dimhoff/ser4010/hardware/schematic/ser4010.kicad_pcb

## KiCad design hardware/schematic/ser4010.kicad_pcb (2018-09-15)

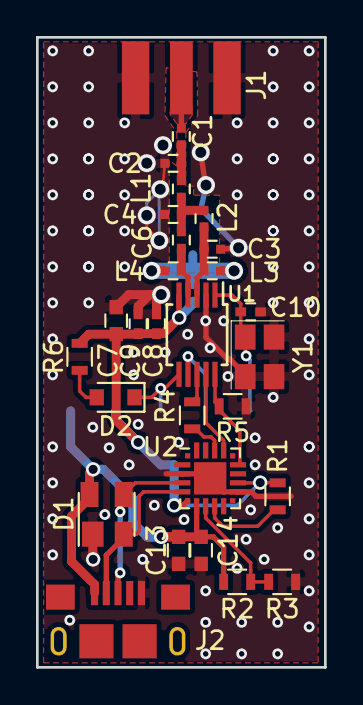
[picture p1: board ser4010.kicad_pcb from above]

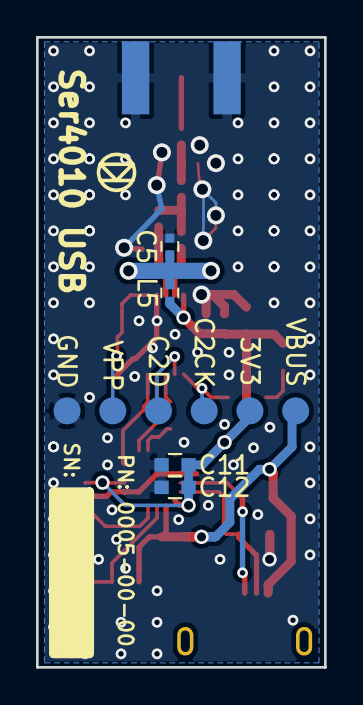
[picture p2: board ser4010.kicad_pcb from below]

Board: 2 copper layers, 16.0 x 35.0 mm, 38 parts (10 on the bottom side), 21 nets.

Parts:
C1, C9: 270pF; C_0402
C2, C4: 6.8pF; C_0402
C3: 4.3pF; C_0402
C5: 2.7pF; C_0402
C6: 1.8pF; C_0402
C7: 2.2uF; C_0603
C8: 1nF; C_0402
C10: 5pF; C_0402
C11, C13: 4.7uF; C_0603
C12, C14: 0.1uF; C_0603
D1: SP0503BAHT; SOT-143
D2: LED; D_0805
J1: Conn_Coaxial; Adafruit-SMA_EDGELAUNCH
J2: USB_OTG; Amphenal_FCI_10118193-0001LF_USB_Micro-B
J3: 3V3; Measurement_Point_Round-SMD-Pad_Small-Labeled
J4: VPP; Measurement_Point_Round-SMD-Pad_Small-Labeled
J5: C2CK; Measurement_Point_Round-SMD-Pad_Small-Labeled
J6: C2D; Measurement_Point_Round-SMD-Pad_Small-Labeled
J7: GND; Measurement_Point_Round-SMD-Pad_Small-Labeled
J8: VBUS; Measurement_Point_Round-SMD-Pad_Small-Labeled
L1: 18nH; C_0402
L2: 56nH; C_0402
L3, L4: 16nH; C_0402
L5: 220nH; C_0402
R1: 1k; R_0603
R2: 22.1k; R_0603
R3: 47.5k; R_0603
R4: 100; R_0603
R5: DNF; R_0603
R6: 470; R_0603
U1: Si4010-GT; MSOP-10_3x3mm_Pitch0.5mm
U2: CP2102N-A01-GQFN20; SiliconLabs_QFN-20-1EP_3x3mm_Pitch0.5mm
Y1: LFXTAL055915; Crystal_SMD_IQD_CFPX-180_4pin_3.2x2.5mm

Connections:
+3V3: C7.1, C8.1, C9.1, C11.1, C12.1, J3.1, L5.1, R1.1, R6.2, U1.5, U2.6, U2.13
/D+: D1.3, J2.3, U2.4
/D-: D1.2, J2.2, U2.5
/VBUS: C13.1, C14.1, D1.4, J2.1, J8.1, R2.1, U2.7
GND: C2.2, C3.2, C4.2, C5.1, C7.2, C8.2, C9.2, C10.1, C11.2, C12.2, C13.2, C14.2, D1.1, J1.2, J2.5, J7.1, R3.2, R5.1, U1.2, U2.3, U2.12, U2.21, Y1.2, Y1.3, Y1.4
unnamed: C1.1, C2.1, L1.2
unnamed: C1.2, J1.1
unnamed: C3.1, L2.1, L3.1, U1.3
unnamed: C4.1, C6.2, L1.1, L2.2
unnamed: C5.2, L3.2, L4.1, L5.2
unnamed: C6.1, L4.2, U1.4
unnamed: C10.2, J4.1, U1.1, Y1.1
unnamed: D2.1, J5.1, U1.6
unnamed: D2.2, R6.1
unnamed: J6.1, U1.7
unnamed: R1.2, U2.9
unnamed: R2.2, R3.1, U2.8
unnamed: R4.1, U1.8
unnamed: R4.2, U2.18
unnamed: R5.2, U1.10, U2.15
unnamed: U1.9, U2.17
