dimhoff/ser4010/(threads)

Thread 2 (2021-05-05):

tunable 433 to 27

xromansx, 2021-05-05:
You indicated in your blog that 4010 is tunable but antena is made more for 433Mhz  in datasheed I didn't find exact components to change the frequency, do you know any universal schematic that can be used ? or what exactly need to be change to be able to use on 27Mhz (except antena itself) .
Thank you.

dimhoff, 2021-05-05:
Not a software issue..

Closed 2021-05-05.
