dimhoff/ser4010/(commit log)

2014-11-07 Replace 'if else' construction with switch case
2014-11-08 Added device type and revision to identify firmware
2015-04-19 Make default serial device a build option
2018-08-11 libser4010: Try to recover from out-of-sync communication
    If a command time outs because it takes very long, libser4010 will
    return an error to the calling program. However if the ser4010 command
    does succeed after the timeout, it will still return a result packet.
    This packet is stored in the OS receive buffer. The next time a command
    is send to the ser4010 device, libser4010 will directly read the
    previous response from the OS buffer. libser4010 would detect this
    response was for a different command, and return an error. In the mean
    time the ser4010 returns a new response for the current command which in
    turn is queued in the OS buffer. This situation will continue till the
    serial port is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
2018-08-11 KAKU: Increase PA power level
2018-08-29 HW: Added initial Ser4010 PCB design
    [ser4010.kicad_pcb, ser4010.sch]
2018-08-29 HW: Switch to di_kicad_library repository for KiCad libs
2018-08-29 HW: fix DI Logo orientation
    [ser4010.kicad_pcb]
2018-08-29 Add info about SER4010-USB PCB in README.md
2018-08-29 HW: add gitignore files for KiCad files and datasheets
2018-08-29 HW: Use updated Si4010-GT symbol
    [ser4010.sch]
2018-09-15 HW: fix project number
    [ser4010.kicad_pcb, ser4010.sch]
2019-02-27 HW: add part information
    [ser4010.sch]
