dimhoff/ser4010/(notices)

Notices in the files:
hardware/schematic/ser4010.kicad_pcb:
Copyright (c) 2018, David Imhoff
License: BSD-3-Clause
